Astreubel/Bachelorthesis/Hardware/Fotos/dmx_ports.jpg

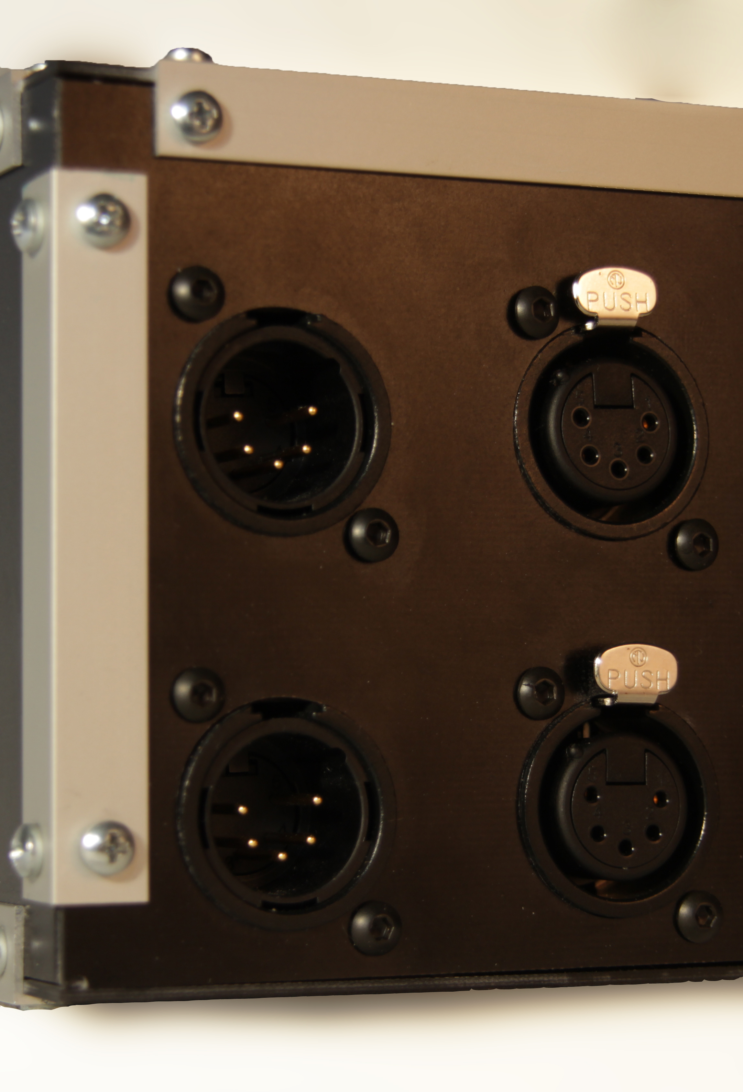
Hardware/Fotos/dmx_ports.jpg
