Astreubel/Bachelorthesis/Hardware/Fotos/schraeg_hinten.jpg

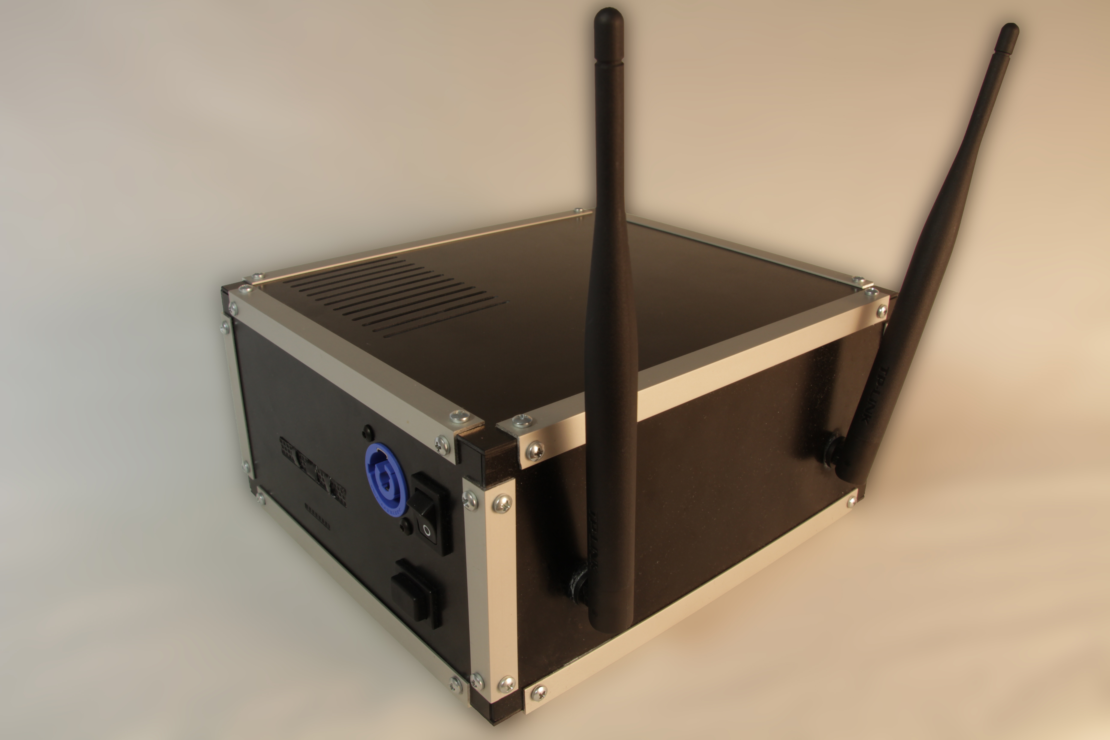
Hardware/Fotos/schraeg_hinten.jpg
