Astreubel/Bachelorthesis/README.md

Bachelorthesis
==============

Diese Arbeit befasst sich mit der Konzeption und Realisierung eines offenen und erweiterbaren Systems zur Protokollwandlung und DMX512-Ausgabe. Die verwendete Hardwareplattform ist ein Raspberry Pi Model B. Ziel ist dabei die Fertigstellung eines betriebsbereiten Prototypen zum Wandeln zahlreicher Lichtsteuer-Protokolle über Ethernet, Wireless-LAN und die konventionelle DMX512-Schnittstelle. Der Prototyp soll in seiner Konstruktion den Anforderungen der Veranstaltungstechnik angepasst sein, also standardisierte und bewährte Steckverbindersysteme und eine solide Gehäusekonstruktion aufweisen. Des Weiteren soll dieser modular aufgebaut sein, um Erweiterbarkeit und einfache Wartung zu gewährleisten. Dies wird durch die Herstellung einer Add-On-Platine bewerkstelligt, welche den Raspberry Pi um analoge Eingänge, PWM-Ausgänge und Steckverbinder für weitere Peripherie ergänzt. Weiterhin ist die Vermittlung aller notwendiger Grundlagen, die zum Verstehen und Betreiben von zukünftigen Lichtsteuernetzwerken benötigt werden, sowie eine Übersicht, der aktuell am Markt befindlichen Ethernet-fähigen Lichttechnik, Inhalt dieser Arbeit.
