Astreubel/Bachelorthesis/Hardware/Boardlayout/Boardlayout_Erweiterungsboard.png

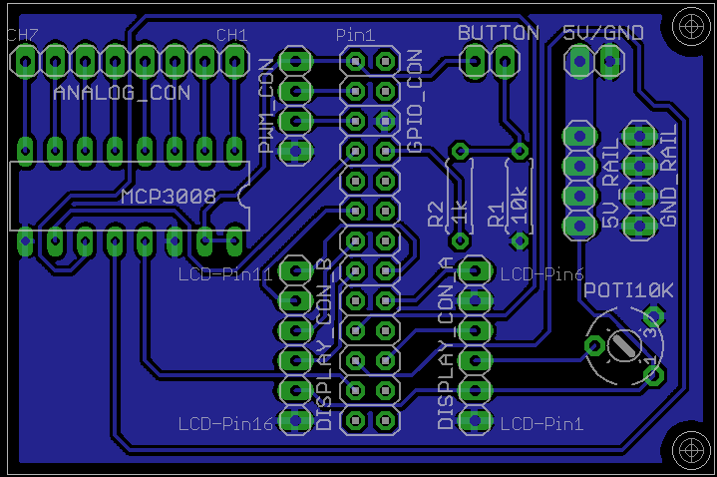
Hardware/Boardlayout/Boardlayout_Erweiterungsboard.png
