Astreubel/Bachelorthesis/Hardware/Fotos/anschluesse.jpg

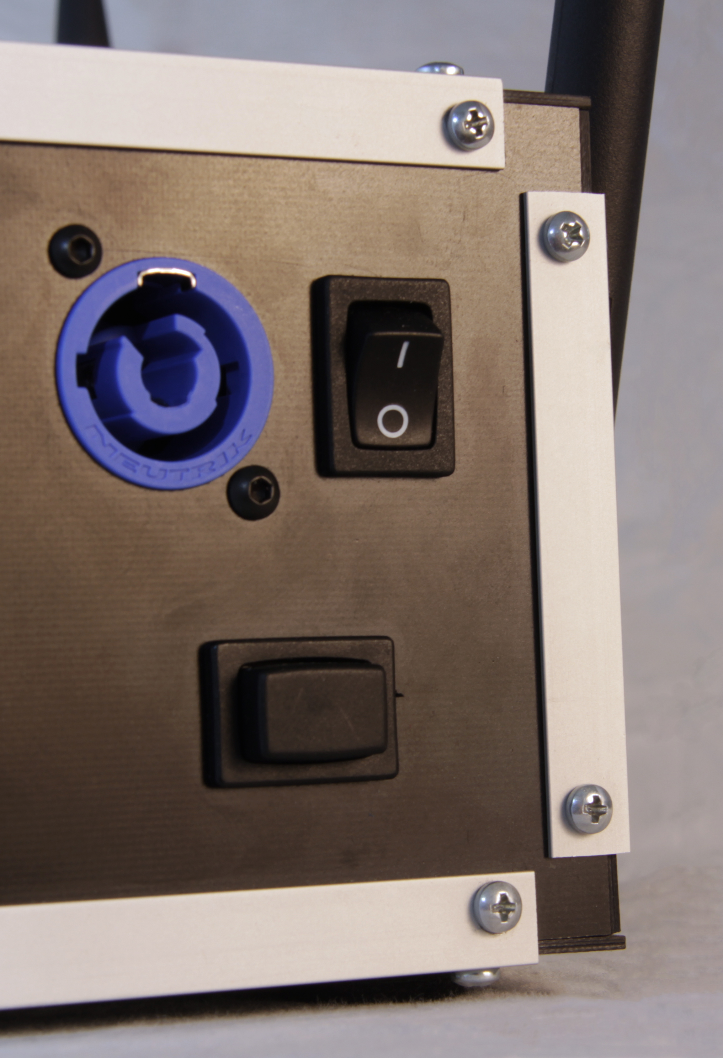
Hardware/Fotos/anschluesse.jpg
