Astreubel/Bachelorthesis/Hardware/Fotos/display.jpg

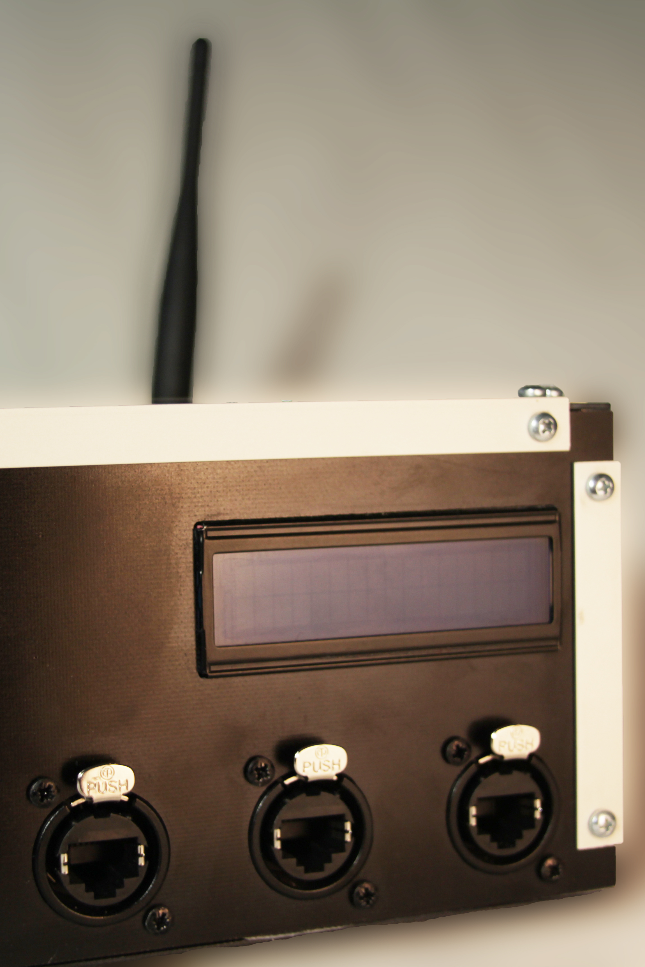
Hardware/Fotos/display.jpg
