Astreubel/Bachelorthesis/Hardware/Fotos/front.jpg

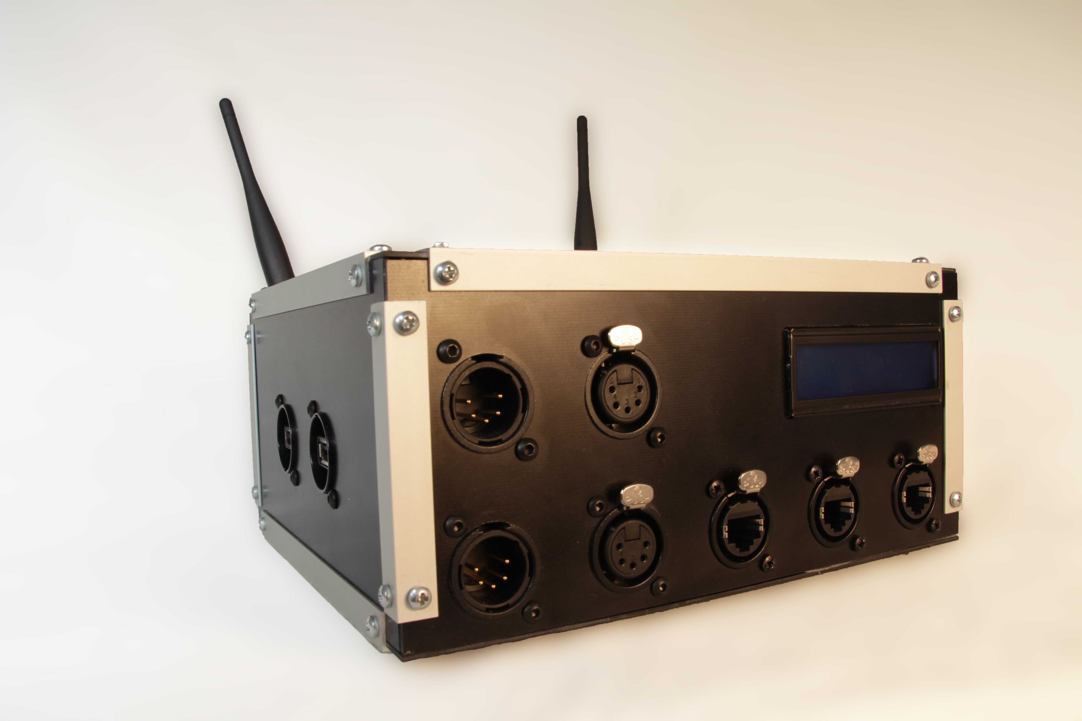
Hardware/Fotos/front.jpg
