Astreubel/Bachelorthesis/Hardware/Fotos/schraeg_vorn.jpg

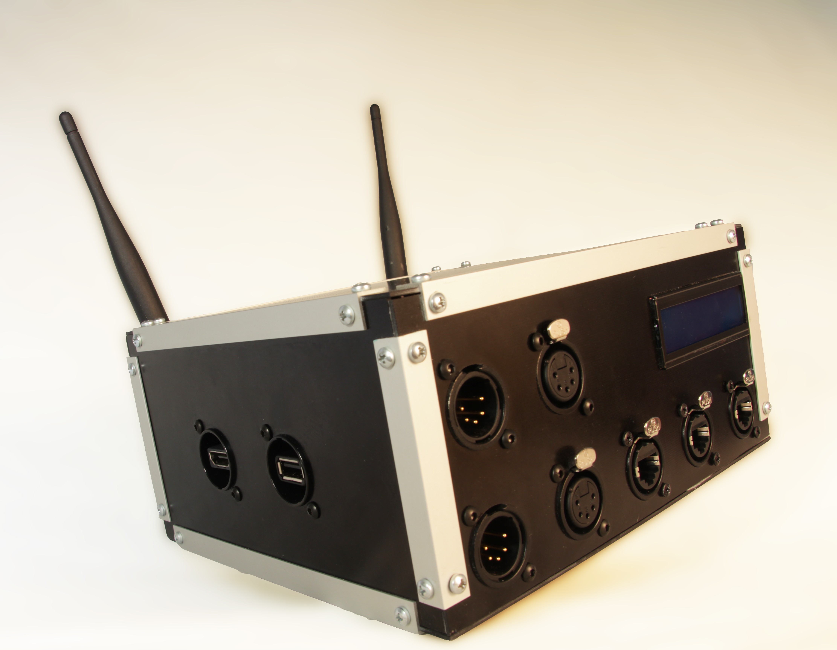
Hardware/Fotos/schraeg_vorn.jpg
