Astreubel/Bachelorthesis/Hardware/Technische_Zeichnungen/Renderings/Renderings_zusammengefuegt_vorlaeufig.jpg

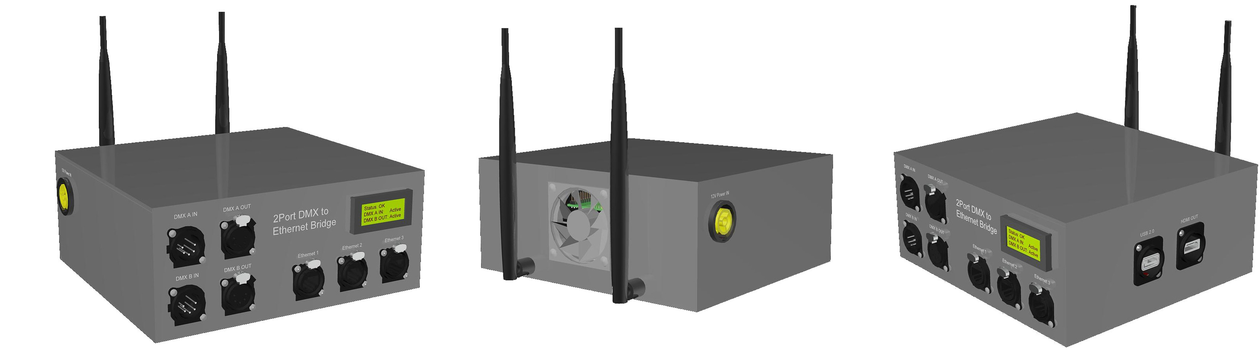
Hardware/Technische_Zeichnungen/Renderings/Renderings_zusammengefuegt_vorlaeufig.jpg
