Astreubel/Bachelorthesis/Hardware/Technische_Zeichnungen/Renderings/uebersicht_endgueltige_Konstruktion.jpg

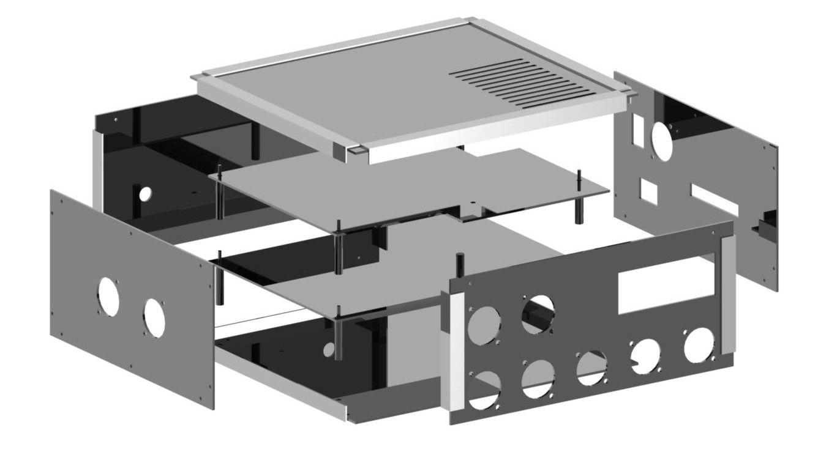
Hardware/Technische_Zeichnungen/Renderings/uebersicht_endgueltige_Konstruktion.jpg
