Astreubel/Bachelorthesis/Hardware/Boardlayout/Aetzvorlage.pdf

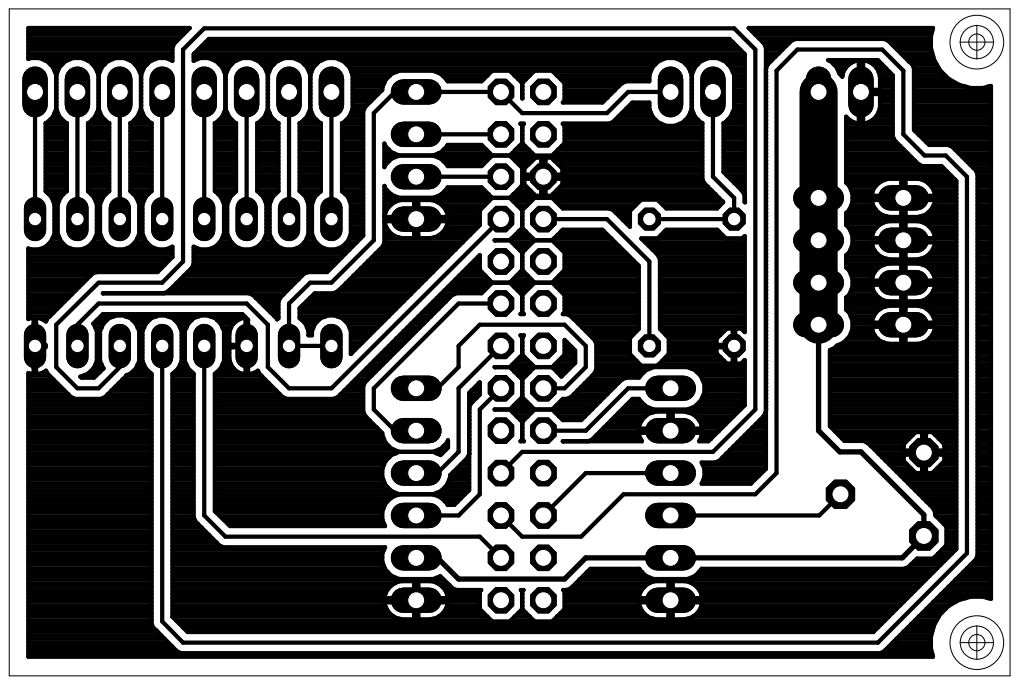
[picture p10: page 1]
