Astreubel/Bachelorthesis/Hardware/Boardlayout/Erweiterungsboard_Raspi_schematic.pdf

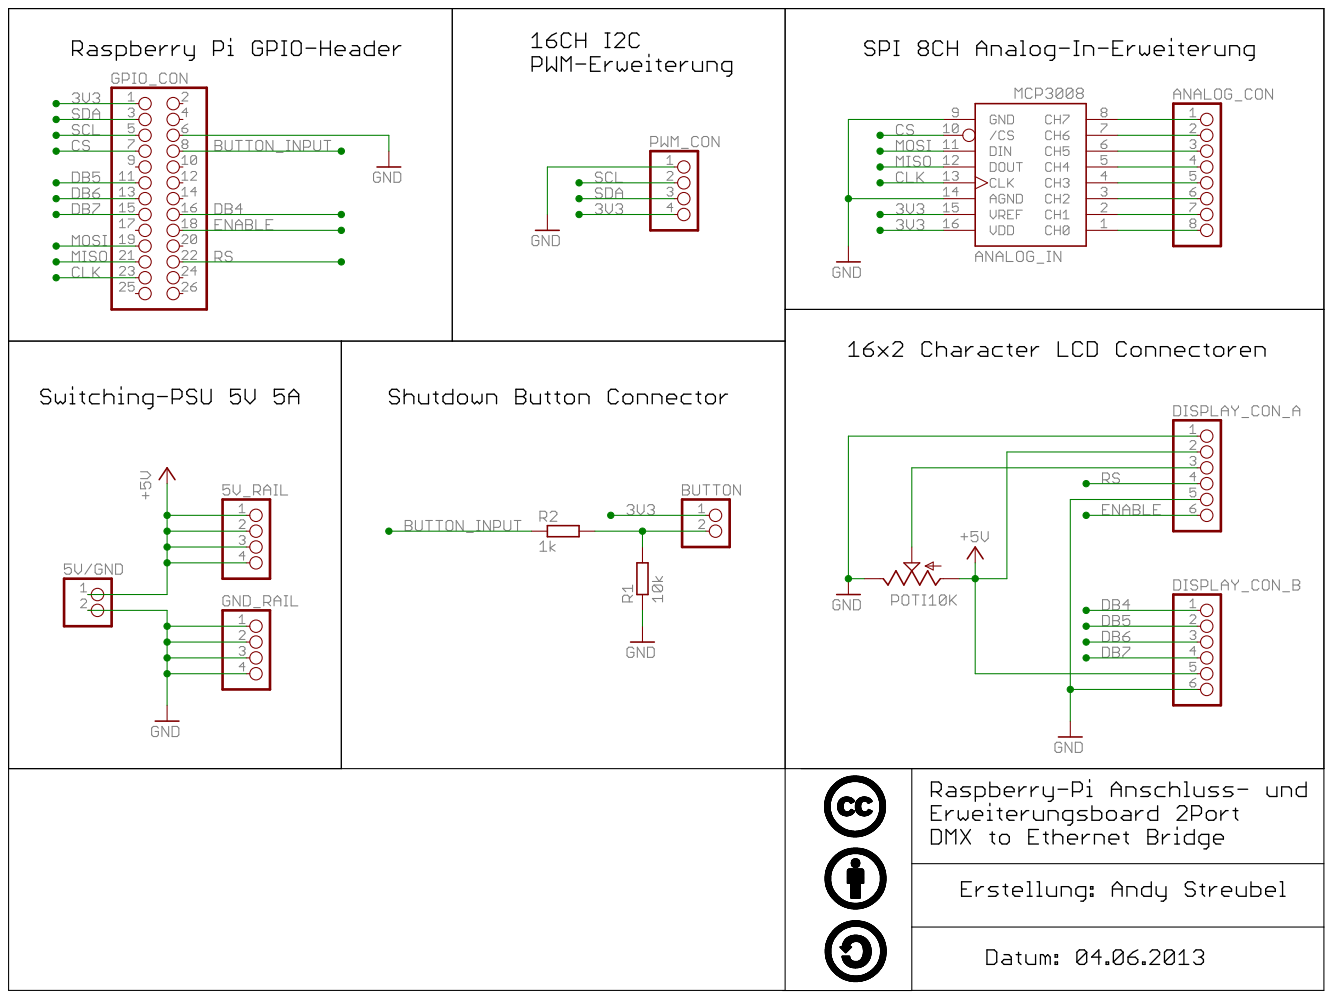
[picture p11: page 1]
