Astreubel/Bachelorthesis/Hardware/Technische_Zeichnungen/Fertigungszeichnungen/td1.pdf

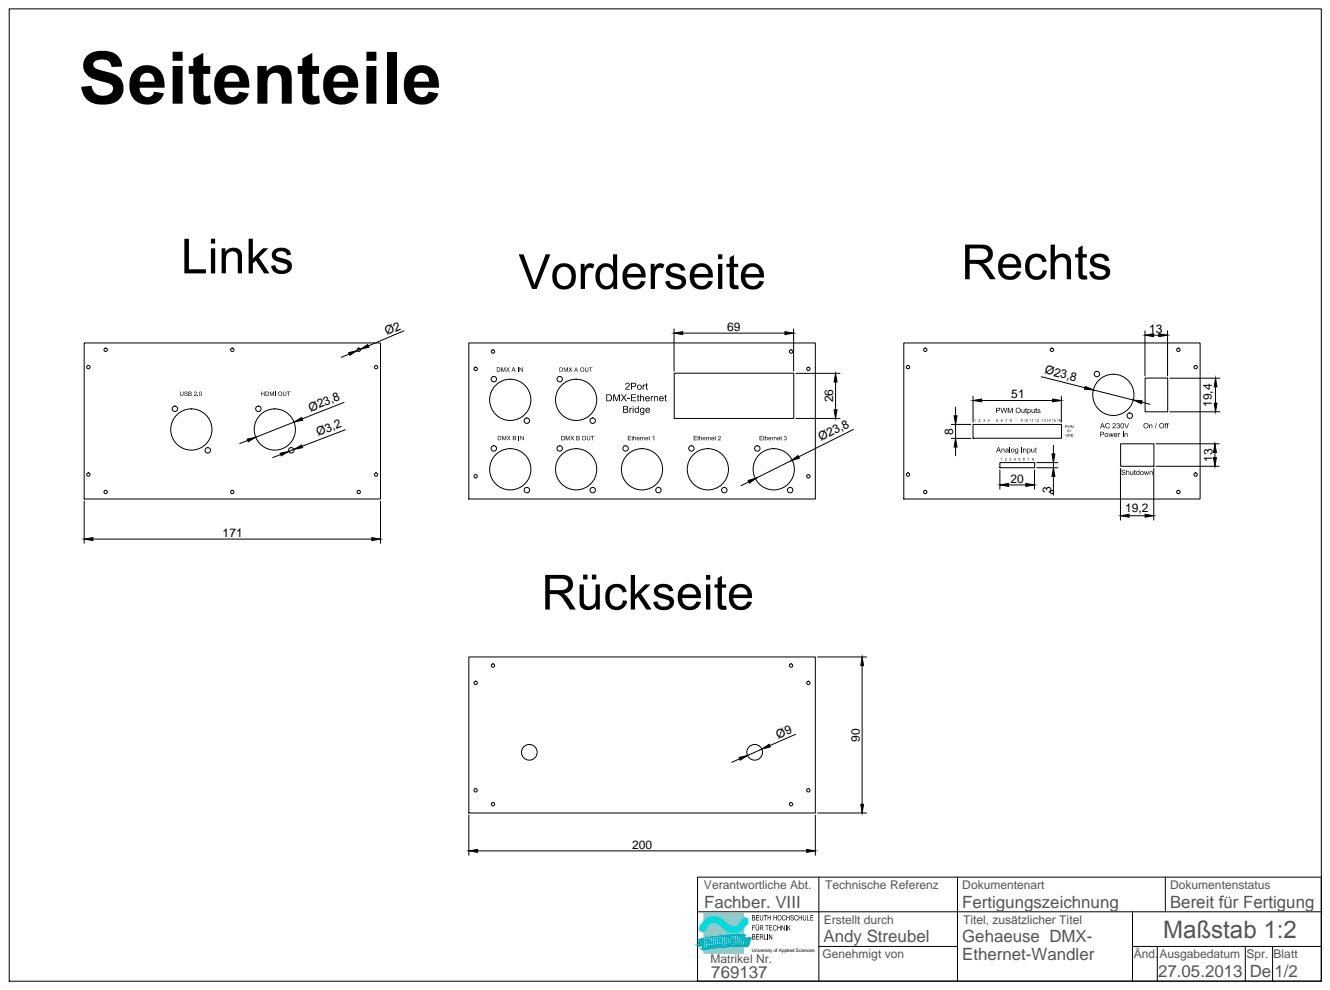
[picture p12: page 1]

Ø 200 Verantwortliche Abt. Technische Referenz Erstellt durch Genehmigt von Dokumentenart Dokumentenstatus bQGAusgabedatum Spr. Blatt 7LWHO]XVlW]OLFKHU7LWHO University of Applied Sciences Matrikel Nr. Andy Streubel 769137 Gehaeuse DMX- Ethernet-Wandler 0DßVWDE 27.05.2013 1/2De Fachber. VIII Fertigungszeichnung %HUHLWIüU)HUWLJXQJ
