Astreubel/Bachelorthesis/(commit log)

2013-06-06 Neuordnung Unterordner + Hinzufügen von Eagle-Boardlayout
    [Con_Raspi.brd, Con_Raspi.sch]
2013-09-25 Hinzufügen der Bachelorarbeit (PDF)
