Astreubel/Bachelorthesis/(notices)

Notices in the files:
Hardware/Boardlayout/Eagle_Files/Con_Raspi.sch:
media/CA222A25222A16CB/Users/Andy/Downloads/Creative Commons/cc.large.bmp
media/CA222A25222A16CB/Users/Andy/Downloads/Creative Commons/sa.large.bmp
